CosmoTheoretician/acoustic-aircraft-array/out/analysis/doa_vs_elevation.png

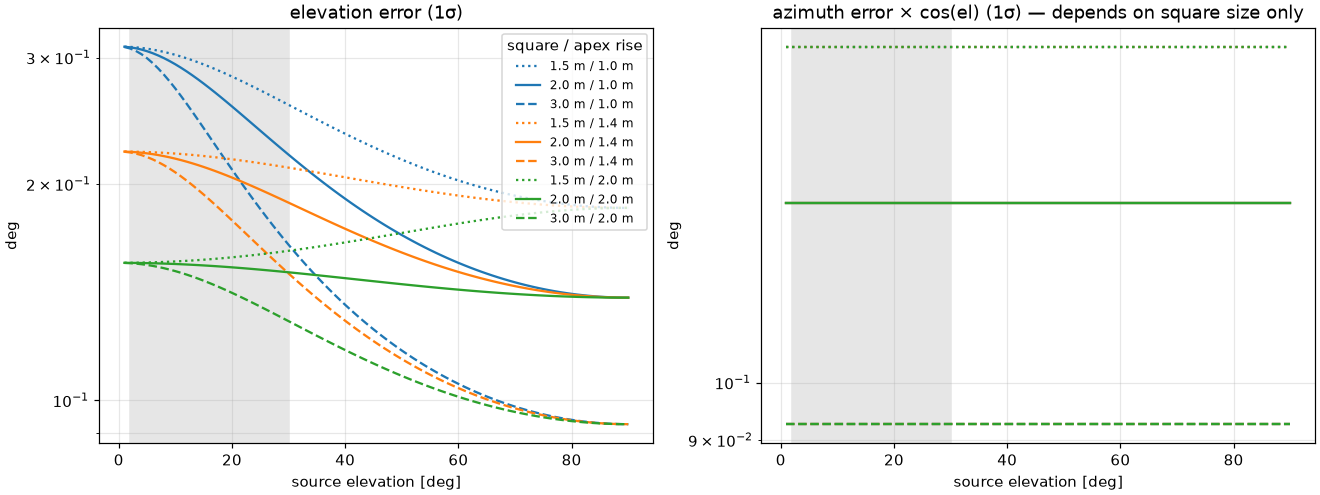
out/analysis/doa_vs_elevation.png
