CosmoTheoretician/acoustic-aircraft-array/out/analysis/tracking_nominal.png

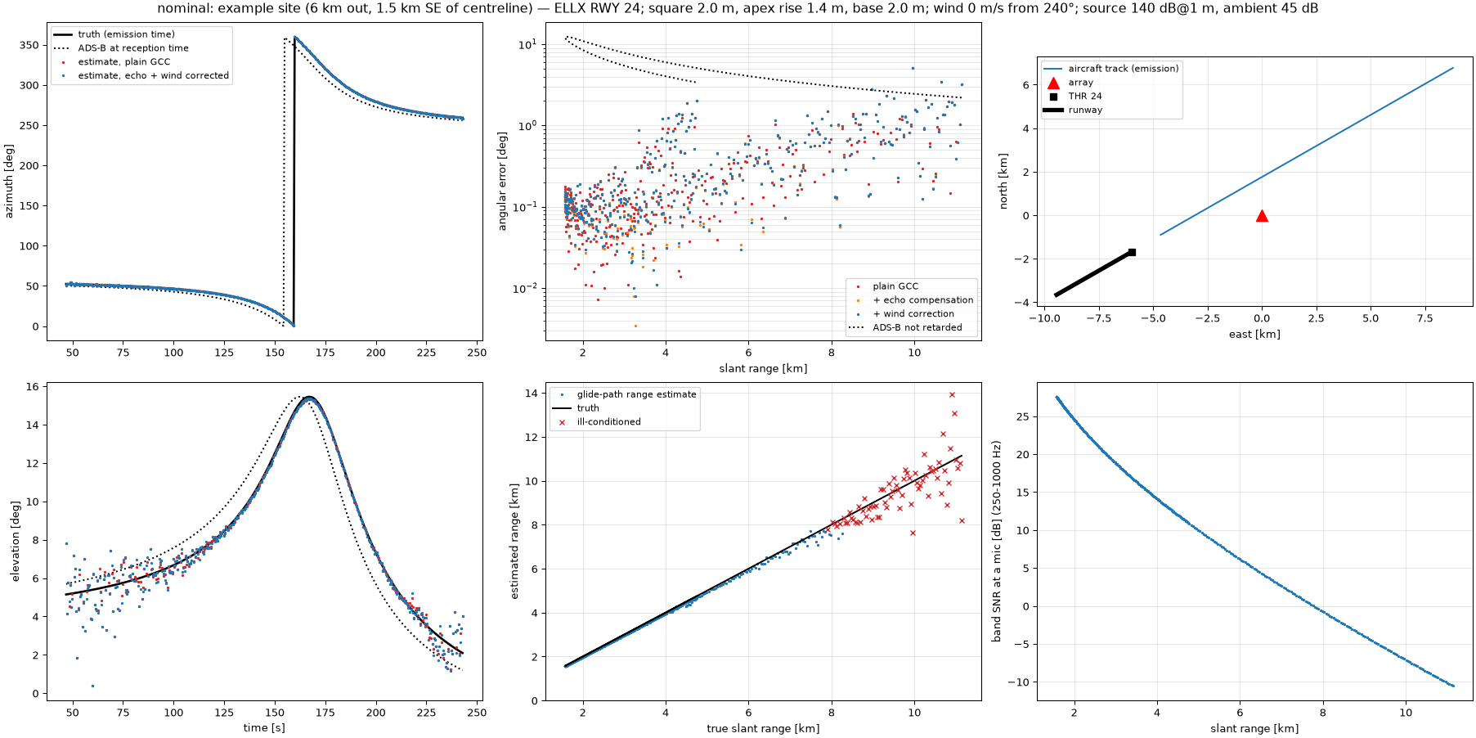
out/analysis/tracking_nominal.png
