CosmoTheoretician/acoustic-aircraft-array/out/render/cpe_closeup.png

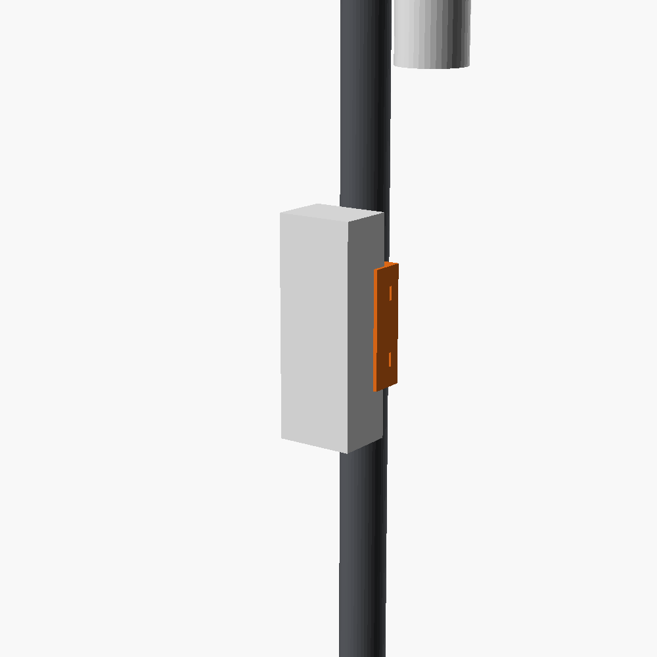
out/render/cpe_closeup.png
