CosmoTheoretician/acoustic-aircraft-array/out/render/iso_northwest.png

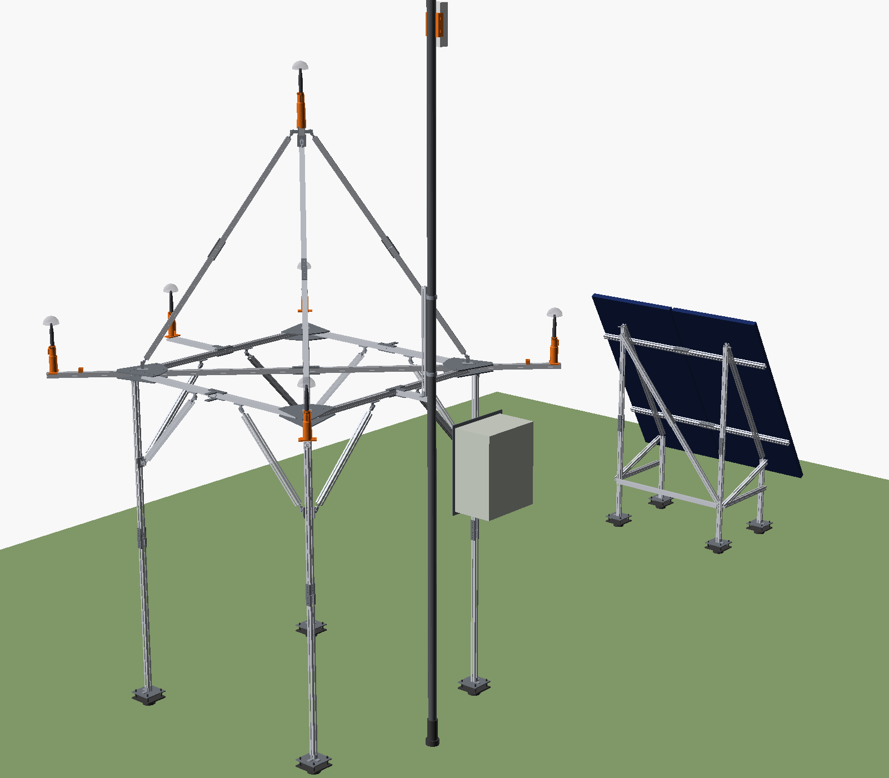
out/render/iso_northwest.png
