CosmoTheoretician/acoustic-aircraft-array/out/render/iso_southeast.png

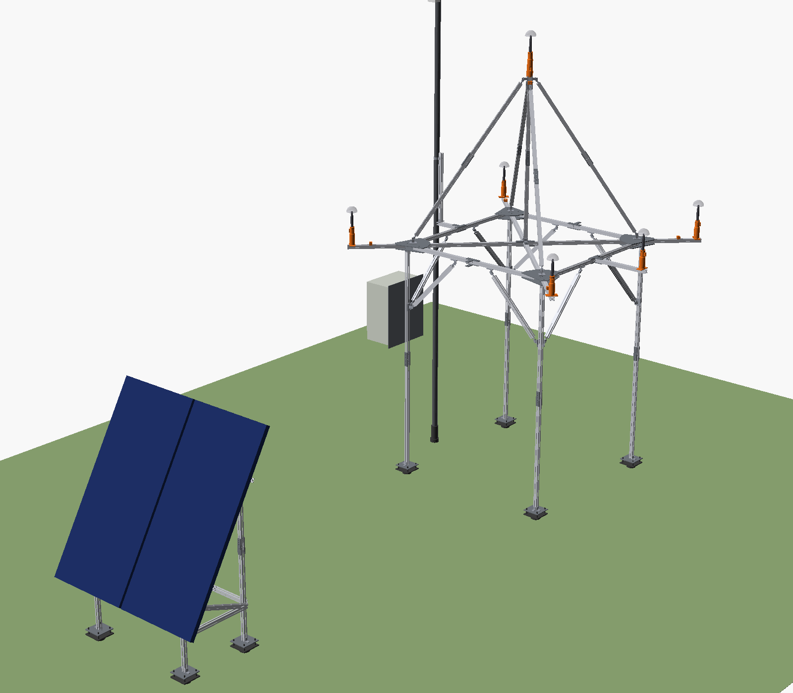
out/render/iso_southeast.png
