CosmoTheoretician/acoustic-aircraft-array/out/render/south_elevation.png

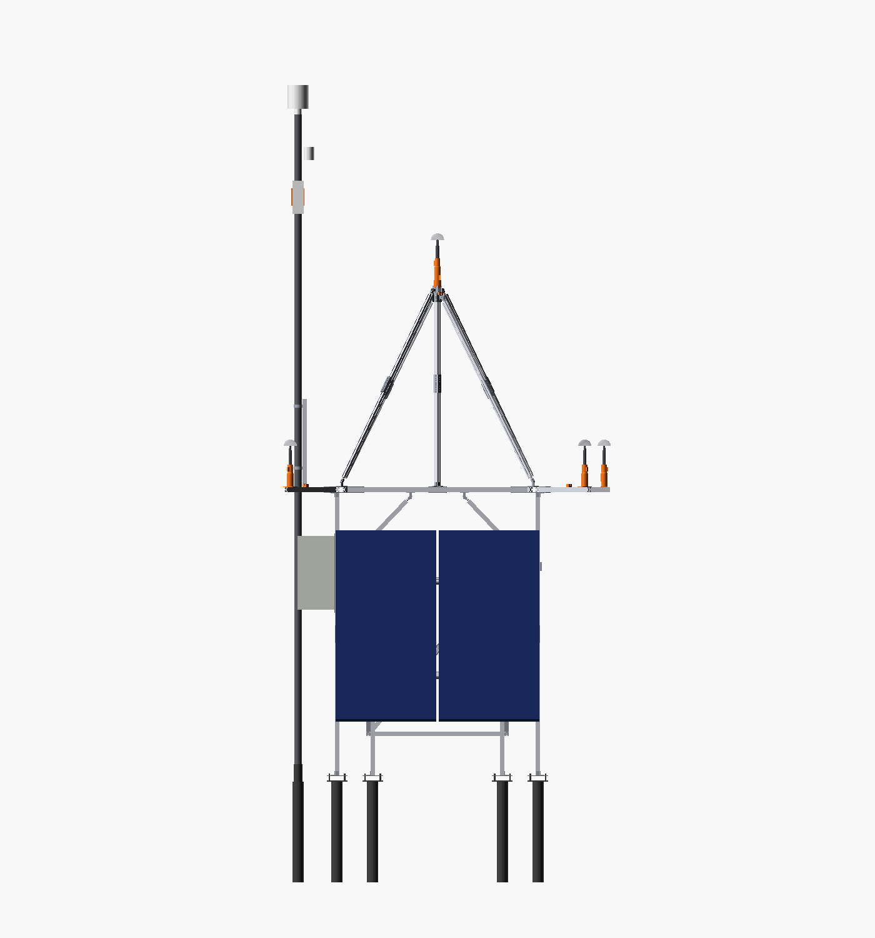
out/render/south_elevation.png
