CosmoTheoretician/acoustic-aircraft-array/out/render/top.png

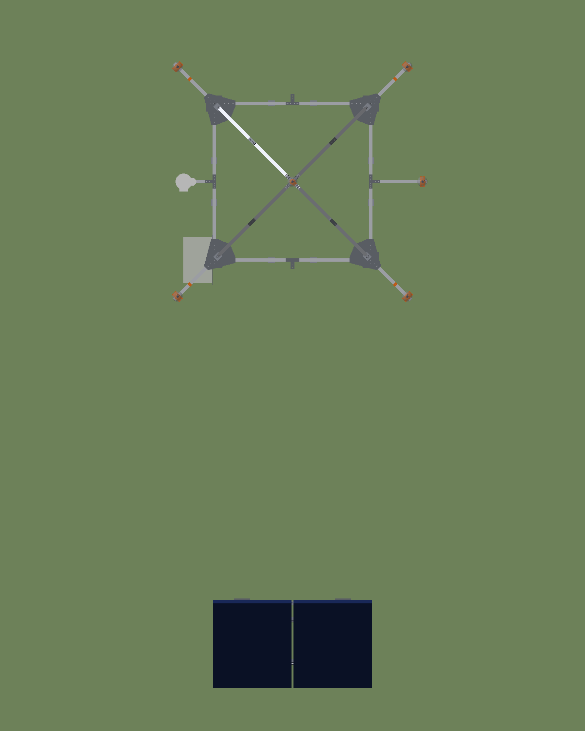
out/render/top.png
