CosmoTheoretician/acoustic-aircraft-array/out/bom.csv

category | item | spec | qty | notes
profile | 3030 extrusion — arm | cut 874.2 mm, square ends | 4 | H7 through-hole 20 mm from outer end, 27 mm from hub end
profile | 3030 extrusion — outrigger | cut 470.0 mm, square ends | 4 | H7 through-holes 20 mm from inner end and 430 mm (mic holder dowel)
profile | 3030 extrusion — side_half | cut 610.3 mm, square ends | 8 | H7 through-holes 20 mm from the corner end, 30 mm from the mid end, and 430 mm from the corner end (knee-brace clevis, underside) (standard lugs: no pre-drilled hole, match-drill through the lug)
profile | 3030 extrusion — leg | cut 958.0 mm, square ends | 8 | tap core M8 both ends; H7 through-holes at 1418 mm from the foot (knee clevises, 2 faces) (standard lugs: no pre-drilled hole, match-drill through the lug); spliced end(s): through-hole 30 mm from end
profile | 3030 extrusion — knee_brace | cut 575.7 mm, square ends | 8 | tap core M8 both ends for fork heads; pin-to-pin 655.7 mm: set once on the jig, lock the jam nuts, paint-mark the threads
profile | 3030 extrusion — strut_A | cut 742.6 mm, square ends | 4 | tap core M8 both ends for fork heads; pin-to-pin 1567.2 mm: set once on the jig, lock the jam nuts, paint-mark the threads; spliced end(s): through-hole 30 mm from end
profile | 3030 extrusion — strut_B | cut 721.9 mm, square ends | 4 | tap core M8 both ends for fork heads; pin-to-pin 1525.9 mm: set once on the jig, lock the jam nuts, paint-mark the threads; spliced end(s): through-hole 30 mm from end
profile | 3030 extrusion — mast | cut 696.0 mm, square ends | 2 | tap core M8 both ends; H7 dowel holes at clevis heights 1334 and 1284 mm from foot (standard lugs: no pre-drilled hole, match-drill through the lug); spliced end(s): through-hole 30 mm from end
profile | 3030 extrusion — outrigger | cut 470.0 mm, square ends | 1 | (mic 6) same as corner outriggers
profile | 3030 extrusion — solar_rail | cut 1100.0 mm, square ends | 2 | H7 holes at both ends (post brackets)
profile | 3030 extrusion — solar_post | cut 721.5 mm, square ends | 4 | tap core M8 at the foot; spliced end(s): through-hole 30 mm from end
profile | 3030 extrusion — solar_post | cut 492.3 mm, square ends | 2 | tap core M8 at the foot
profile | 3030 extrusion — solar_tie | cut 550.0 mm, square ends | 2 | bolt through the post side slots (corner brackets)
profile | 3030 extrusion — solar_diagonal | cut 584.3 mm, square ends | 2 | drilled ends, M6 through-bolt to the post
profile | 3030 extrusion — solar_back_tie | cut 880.0 mm, square ends | 1 | corner brackets to the back posts
profile | 3030 extrusion — solar_back_diagonal | cut 699.4 mm, square ends | 2 | drilled ends, M6 through-bolt to the posts; spliced end(s): through-hole 30 mm from end
profile | 3030 extrusion — solar_cross_rail | cut 689.0 mm, square ends | 4 | panel clamps; bolt to the inclined rails with corner brackets; spliced end(s): through-hole 30 mm from end
profile | 3030 extrusion — pole_stub | cut 250.0 mm, square ends | 1 | H7 through-hole 20 mm from inner end
profile | 3030 extrusion — pole_post | cut 600.0 mm, square ends | 1 | tap core bottom end
profile | 3030 extrusion — total length | 44.47 m (+ saw kerf)
plate | hub_top | catalogue cross joining plate 3030, arms 30 wide, ~154 tip to tip, t=6 mm, envelope 130 x 130 mm, DXF plates/hub_top.dxf | 1 | match-drill the dowel holes in place with the jig (ream H7), then number the plate; 4 dowel holes 6 H7 (ream), other holes per DXF
plate | hub_bottom | catalogue cross joining plate 3030, arms 30 wide, ~154 tip to tip, t=6 mm, envelope 130 x 130 mm, DXF plates/hub_bottom.dxf | 1 | match-drill the dowel holes in place with the jig (ream H7), then number the plate; 4 dowel holes 6 H7 (ream), other holes per DXF
plate | corner_gusset | Al 5083/6082, t=6 mm, envelope 273 x 273 mm, DXF plates/corner_gusset.dxf | 8 | 4 dowel holes 6 H7 (ream), other holes per DXF
plate | splice | catalogue straight joining plate 3030, ~122 x 30, t=6 mm, envelope 122 x 30 mm, DXF plates/splice.dxf | 28 | match-drill the dowel holes in place with the jig (ream H7), then number the plate; 2 dowel holes 6 H7 (ream), other holes per DXF
plate | leg_base | galvanised steel flat plate (S235), drilled per DXF, t=6 mm, envelope 140 x 140 mm, DXF plates/leg_base.dxf | 8 | no dowels: levelling studs set the height; 0 dowel holes 6 H7 (ream), other holes per DXF
plate | midside_tee | catalogue T joining plate 3030, ~95 x 123, t=6 mm, envelope 95 x 123 mm, DXF plates/midside_tee.dxf | 8 | match-drill the dowel holes in place with the jig (ream H7), then number the plate; 3 dowel holes 6 H7 (ream), other holes per DXF
bought | Corner bracket 3030 (28x28 cast) |  | 34
bought | Ground screw 76 x 650 mm with 140 x 140 mm head plate, galvanised |  | 8
bought | Al T-section 50x50x5 stock, 60 mm pieces (web trimmed to 18 mm, 8.2 mm pin hole at 32 mm, 2 x 6.6 + 1 dowel hole) — pin lug |  | 24
bought | Fork head DIN 71752 G8x16, stainless (A4) (pin: see clevis pins) |  | 24
bought | Al plate 540 x 440 x 4 mm (box mounting plate on leg) |  | 1
bought | Weatherproof enclosure 400x500x250 mm IP66, vent membrane + cable glands |  | 1
bought | PV panel ~200 W 12 V mono, 680 x 1480 x 35 mm |  | 2
bought | MPPT charge controller 12 V 20 A with low-temperature charge cut-off (LiFePO4) |  | 1
bought | LiFePO4 battery 12.8 V 100 Ah (~1.3 kWh, ~2 days at the ~25 W system load), in the box |  | 1
bought | PV cable 4 mm2 ~6 m in buried/armoured conduit + MC4 + 15 A fuse |  | 1
bought | Ground screw 76 x 650 mm with 48.3 mm pole sleeve + clamp bolt, galvanised |  | 1
bought | Aluminium or galvanised tube 48.3 mm, 4.8 m (2 parts + internal sleeve joint for transport) |  | 1
bought | U-bolt pole clamp for 48.3 mm pole onto 3030 slot, A4 |  | 2
bought | Ultrasonic 2D wind sensor (e.g. Gill WindSonic class), ~142 mm, pole-top mount |  | 1
bought | TP-Link CPE210 (2.4 GHz, 9 dBi, 65 deg H / 35 deg V beam) + its pole strap |  | 1
bought | Hose clamp 12 mm W4 stainless, 40-70 mm (spare strap for the CPE saddle) |  | 1
bought | Sky camera + pole bracket (user supplied) |  | 1
bought | Armoured / steel-braided cable conduit, marten-proof (all cables, legs to box) |  | 1
fastener | Clevis pin 8 x 24 mm DIN 1444, A4 + R-clip |  | 24 | add ~10 % spares
fastener | Dowel pin 6 m6 x 20 ISO 8734, stainless 1.4305 |  | 145 | add ~10 % spares
fastener | M10 threaded rod 90 mm A4 + 3 nuts + 2 washers (levelling stud) |  | 32 | add ~10 % spares
fastener | M3x16 socket head + M3 nut, A4 (collar) |  | 6 | add ~10 % spares
fastener | M4x30 socket head + M4 nyloc, A4 (holder clamp) |  | 6 | add ~10 % spares
fastener | M5x16 + washer A4 (box to plate) |  | 4 | add ~10 % spares
fastener | M6 nyloc nut DIN 985, A4 |  | 48 | add ~10 % spares
fastener | M6 washer DIN 125, A4 |  | 48 | add ~10 % spares
fastener | M6x12 button head ISO 7380, A4 stainless |  | 330 | add ~10 % spares
fastener | M6x20 button head ISO 7380, A4 stainless |  | 48 | add ~10 % spares
fastener | M6x25 button head ISO 7380, A4 stainless |  | 5 | add ~10 % spares
fastener | M6x50 + nyloc A4 (solar diagonal) |  | 4 | add ~10 % spares
fastener | M8 jam nut DIN 439, A4 |  | 24 | add ~10 % spares
fastener | M8x16 socket head ISO 4762, A4 + washer (apex holder -> mast) |  | 1 | add ~10 % spares
fastener | M8x16 socket head ISO 4762, A4 + washer (leg -> gusset / base plate) |  | 8 | add ~10 % spares
fastener | M8x16 socket head ISO 4762, A4 + washer (mast -> hub) |  | 1 | add ~10 % spares
fastener | M8x16 socket head ISO 4762, A4 + washer (post -> stub) |  | 1 | add ~10 % spares
fastener | M8x16 socket head ISO 4762, A4 + washer (solar post -> base plate) |  | 4 | add ~10 % spares
fastener | Nylon washer 8.4 x 16 x 1.5 (fork-head spacer) |  | 48 | add ~10 % spares
fastener | PV mid/end clamp 35 mm frame, aluminium + M8 T-bolt |  | 6 | add ~10 % spares
fastener | T-nut M6 for slot 8 (hammer or drop-in), A2/A4 stainless |  | 335 | add ~10 % spares
printed | mic_holder_flange | ASA, 5 walls, 50 % infill, print flange-down | 5 | stl/mic_holder_flange.stl
printed | iso_sleeve_tpu | TPU 85A-95A (or cut from EPDM tube 22x28 mm) | 6 | stl/iso_sleeve_tpu.stl
printed | index_collar | ASA or PETG | 6 | stl/index_collar.stl
printed | cable_clip | ASA/PETG (TPU also works) | 5 | stl/cable_clip.stl
printed | mic_holder_socket | ASA, 5 walls, 50 % infill, print socket-up | 1 | stl/mic_holder_socket.stl
printed | cpe_pole_saddle | ASA, 4 walls, 40 % infill, print on its side | 1 | stl/cpe_pole_saddle.stl
bought | Foam windscreen + furry cover | ~90 mm ball | 6
bought | XLR cable, outdoor PUR | length to suit box | 6
