CosmoTheoretician/acoustic-aircraft-array/out/cost_estimate.csv

group | item | spec | qty | eur_low | eur_high | comment
frame | 3030 extrusion — arm | 4 x 874 mm | 4 | 28 | 43 | incl. cutting
frame | 3030 extrusion — outrigger | 4 x 470 mm | 4 | 16 | 25 | incl. cutting
frame | 3030 extrusion — side_half | 8 x 610 mm | 8 | 41 | 63 | incl. cutting
frame | 3030 extrusion — leg | 8 x 958 mm | 8 | 61 | 94 | incl. cutting
frame | 3030 extrusion — knee_brace | 8 x 576 mm | 8 | 39 | 60 | incl. cutting
frame | 3030 extrusion — strut_A | 4 x 743 mm | 4 | 24 | 37 | incl. cutting
frame | 3030 extrusion — strut_B | 4 x 722 mm | 4 | 24 | 37 | incl. cutting
frame | 3030 extrusion — mast | 2 x 696 mm | 2 | 11 | 18 | incl. cutting
frame | 3030 extrusion — outrigger | 1 x 470 mm | 1 | 4 | 6 | incl. cutting
frame | 3030 extrusion — solar_rail | 2 x 1100 mm | 2 | 18 | 27 | incl. cutting
frame | 3030 extrusion — solar_post | 4 x 722 mm | 4 | 24 | 37 | incl. cutting
frame | 3030 extrusion — solar_post | 2 x 492 mm | 2 | 8 | 13 | incl. cutting
frame | 3030 extrusion — solar_tie | 2 x 550 mm | 2 | 9 | 15 | incl. cutting
frame | 3030 extrusion — solar_diagonal | 2 x 584 mm | 2 | 10 | 15 | incl. cutting
frame | 3030 extrusion — solar_back_tie | 1 x 880 mm | 1 | 7 | 11 | incl. cutting
frame | 3030 extrusion — solar_back_diagonal | 2 x 699 mm | 2 | 11 | 18 | incl. cutting
frame | 3030 extrusion — solar_cross_rail | 4 x 689 mm | 4 | 23 | 35 | incl. cutting
frame | 3030 extrusion — pole_stub | 1 x 250 mm | 1 | 2 | 4 | incl. cutting
frame | 3030 extrusion — pole_post | 1 x 600 mm | 1 | 5 | 8 | incl. cutting
frame | Cross joining plate 3030, 4-arm (catalogue), match-drilled for dowels + mast [hub_top] | catalogue cross joining plate 3030 | 1 | 6 | 12 | dowels match-drilled
frame | Cross joining plate 3030, 4-arm (catalogue), match-drilled for dowels [hub_bottom] | catalogue cross joining plate 3030 | 1 | 6 | 12 | dowels match-drilled
frame | Plate corner_gusset (6 mm Al, laser/waterjet) | envelope 273 x 273 mm | 8 | 233 | 406 | reamed dowel holes DIY
frame | Straight joining plate 3030, >=120 mm, 4 holes (catalogue), match-drilled [splice] | catalogue straight joining plate 3030 | 28 | 70 | 126 | dowels match-drilled
frame | Galvanised steel base plate ~120 x 120 x 6, drilled to the screw-head studs [leg_base] | galvanised steel flat plate (S235) | 8 | 32 | 64 | dowels match-drilled
frame | T joining plate 3030 (catalogue), match-drilled for dowels [midside_tee] | catalogue T joining plate 3030 | 8 | 24 | 48 | dowels match-drilled
frame | Corner bracket 3030 (28x28 cast) |  | 34 | 27 | 61 | cast Zn/Al, 28x28
frame | Ground screw 76 x 650 mm with 140 x 140 mm head plate, galvanised |  | 8 | 144 | 240 | galvanised, 650 mm
frame | Al T-section 50x50x5 stock, 60 mm pieces (web trimmed to 18 mm, 8.2 mm pin hole at 32 mm, 2 x 6.6 + 1 dowel hole) — pin lug |  | 24 | 24 | 48 | cut from ~1.5 m of stock
frame | Fork head DIN 71752 G8x16, stainless (A4) (pin: see clevis pins) |  | 24 | 72 | 144 | stainless G8x16
frame | Al plate 540 x 440 x 4 mm (box mounting plate on leg) |  | 1 | 15 | 30
frame | Ground screw 76 x 650 mm with 48.3 mm pole sleeve + clamp bolt, galvanised |  | 1 | 25 | 40
fasteners | Clevis pin 8 x 24 mm DIN 1444, A4 + R-clip |  | 26 | 26 | 53
fasteners | Dowel pin 6 m6 x 20 ISO 8734, stainless 1.4305 |  | 160 | 40 | 80
fasteners | M10 threaded rod 90 mm A4 + 3 nuts + 2 washers (levelling stud) |  | 35 | 42 | 77 | per stud set
fasteners | M3x16 socket head + M3 nut, A4 (collar) |  | 7 | 1 | 2
fasteners | M4x30 socket head + M4 nyloc, A4 (holder clamp) |  | 7 | 1 | 3
fasteners | M5x16 + washer A4 (box to plate) |  | 4 | 1 | 1
fasteners | M6 nyloc nut DIN 985, A4 |  | 53 | 4 | 8
fasteners | M6 washer DIN 125, A4 |  | 53 | 2 | 3
fasteners | M6x12 button head ISO 7380, A4 stainless |  | 363 | 44 | 91
fasteners | M6x20 button head ISO 7380, A4 stainless |  | 53 | 6 | 13
fasteners | M6x25 button head ISO 7380, A4 stainless |  | 6 | 1 | 1
fasteners | M6x50 + nyloc A4 (solar diagonal) |  | 4 | 2 | 3
fasteners | M8 jam nut DIN 439, A4 |  | 26 | 2 | 5
fasteners | M8x16 socket head ISO 4762, A4 + washer (apex holder -> mast) |  | 1 | 0 | 1
fasteners | M8x16 socket head ISO 4762, A4 + washer (leg -> gusset / base plate) |  | 9 | 2 | 4
fasteners | M8x16 socket head ISO 4762, A4 + washer (mast -> hub) |  | 1 | 0 | 1
fasteners | M8x16 socket head ISO 4762, A4 + washer (post -> stub) |  | 1 | 0 | 1
fasteners | M8x16 socket head ISO 4762, A4 + washer (solar post -> base plate) |  | 4 | 1 | 2
fasteners | Nylon washer 8.4 x 16 x 1.5 (fork-head spacer) |  | 53 | 3 | 6
fasteners | PV mid/end clamp 35 mm frame, aluminium + M8 T-bolt |  | 7 | 16 | 33
fasteners | T-nut M6 for slot 8 (hammer or drop-in), A2/A4 stainless |  | 369 | 111 | 221 | stainless hammer nuts
printed | mic_holder_flange | ASA, 5 walls, 50 % infill, print flange-down | 5 | 8 | 15 | filament only
printed | iso_sleeve_tpu | TPU 85A-95A (or cut from EPDM tube 22x28 mm) | 6 | 3 | 9 | filament only
printed | index_collar | ASA or PETG | 6 | 9 | 18 | filament only
printed | cable_clip | ASA/PETG (TPU also works) | 5 | 2 | 8 | filament only
printed | mic_holder_socket | ASA, 5 walls, 50 % infill, print socket-up | 1 | 2 | 3 | filament only
printed | cpe_pole_saddle | ASA, 4 walls, 40 % infill, print on its side | 1 | 2 | 3 | filament only
pole | Aluminium or galvanised tube 48.3 mm, 4.8 m (2 parts + internal sleeve joint for transport) |  | 1 | 45 | 90 | incl. internal sleeve
pole | U-bolt pole clamp for 48.3 mm pole onto 3030 slot, A4 |  | 2 | 12 | 24
pole | Hose clamp 12 mm W4 stainless, 40-70 mm (spare strap for the CPE saddle) |  | 1 | 2 | 3
pole | Earth rod + 16 mm2 cable for the pole (tallest point in the garden) |  | 1 | 30 | 60
microphones | Foam windscreen + furry cover | ~90 mm ball | 6 | 48 | 150 | foam + furry cover
microphones | XLR cable, outdoor PUR | length to suit box | 6 | 90 | 180 | PUR outdoor, 5-8 m
microphones | Behringer ECM8000 measurement mic (5 + optional 6th) |  | 6 | 150 | 240
sensors | Ultrasonic 2D wind sensor (e.g. Gill WindSonic class), ~142 mm, pole-top mount |  | 1 | 250 | 1400 | generic RS485 ultrasonic ... Gill WindSonic
sensors | Sky camera + pole bracket (user supplied) |  | 1 | 60 | 250 | e.g. Raspberry Pi HQ camera + fisheye + housing
electronics | Audio interface, 8 phantom-powered inputs, one sample clock (e.g. Behringer UMC1820) |  | 1 | 230 | 320 | all mics on ONE converter clock; TDOA needs it
electronics | 12 V -> 230 V pure-sine inverter 150 W (for a mains-powered interface) |  | 1 | 50 | 100 | skip if the interface runs on 12 V DC
electronics | Raspberry Pi 5 8 GB + case + NVMe SSD + 12 V->5 V 5 A converter |  | 1 | 140 | 210
electronics | ADS-B receiver: RTL-SDR v4 + 1090 MHz filter + antenna |  | 1 | 70 | 130 | validation truth
network | TP-Link CPE210 (2.4 GHz, 9 dBi, 65 deg H / 35 deg V beam) + its pole strap |  | 1 | 40 | 55
network | TP-Link CPE210, far end of the link (at the house) + PoE injector |  | 1 | 40 | 55 | a link needs 2
network | Outdoor Ethernet cable (CAT6 PE) for the CPE210, ~10 m + glands |  | 1 | 15 | 30
power | Weatherproof enclosure 400x500x250 mm IP66, vent membrane + cable glands |  | 1 | 80 | 160 | polycarbonate IP66 (Fibox/Spelsberg class)
power | PV panel ~200 W 12 V mono, 680 x 1480 x 35 mm |  | 2 | 160 | 260 | 200 W mono
power | MPPT charge controller 12 V 20 A with low-temperature charge cut-off (LiFePO4) |  | 1 | 90 | 130 | e.g. Victron SmartSolar 100/20
power | LiFePO4 battery 12.8 V 100 Ah (~1.3 kWh, ~2 days at the ~25 W system load), in the box |  | 1 | 250 | 400 | with low-temperature charge protection
power | PV cable 4 mm2 ~6 m in buried/armoured conduit + MC4 + 15 A fuse |  | 1 | 30 | 60
power | Armoured / steel-braided cable conduit, marten-proof (all cables, legs to box) |  | 1 | 90 | 180 | ~25-30 m
power | Box internals: DIN rail, fuses, terminals, DC-DC 12->24 V passive PoE |  | 1 | 40 | 80
tools | Reamers 6 H7 (dowels) + 8 H8 (pins), M8 tap, drill-jig bushings |  | 1 | 50 | 100 | DIY machining
tools | Core tapping of profile ends (if done by the extrusion shop) |  | 30 | 30 | 60 | or DIY with the tap
TOTAL |  |  |  | 3465 | 7188
