CosmoTheoretician/acoustic-aircraft-array/out/array_assembly.step

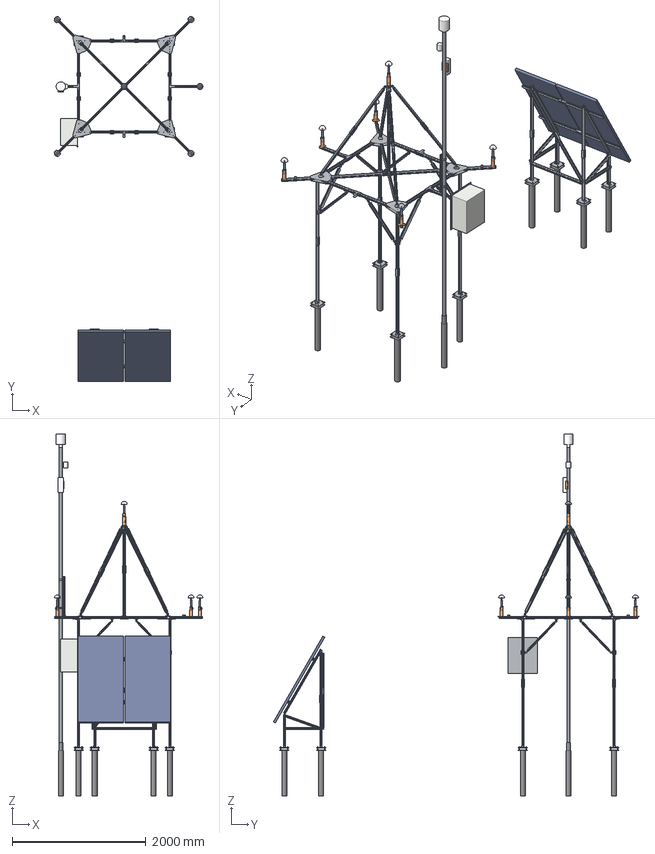
[picture p20: CAD file, 2026-11-10]
out/array_assembly.step
2225.6 x 5459.9 x 5410.0 mm
plate_hub_top_1
plate_hub_bottom_1
arm_1
outrigger_1
side_half_1
side_half_2
plate_corner_gusset_1
plate_corner_gusset_2
leg_1
leg_2
plate_splice_1
plate_splice_2
angle_bracket_1
angle_bracket_2
plate_leg_base_1
angle_bracket_3
angle_bracket_4
ground_screw_1
pin_lug_1
clevis_pin_1
pin_lug_2
clevis_pin_2
knee_brace_1
fork_head_1
fork_head_2
pin_lug_3
clevis_pin_3
pin_lug_4
clevis_pin_4
knee_brace_2
fork_head_3
fork_head_4
pin_lug_5
clevis_pin_5
pin_lug_6
clevis_pin_6
strut_A_1
strut_A_2
plate_splice_3
plate_splice_4
fork_head_5
fork_head_6
print_mic_holder_flange_1
mic_1
print_sleeve_tpu_1
print_index_collar_1
xlr_plug_1
windscreen_keepout_1
print_cable_clip_1
arm_2
outrigger_2
side_half_3
side_half_4
plate_corner_gusset_3
plate_corner_gusset_4
leg_3
leg_4
plate_splice_5
plate_splice_6
angle_bracket_5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
