CosmoTheoretician/acoustic-aircraft-array/out/plates/splice.dxf

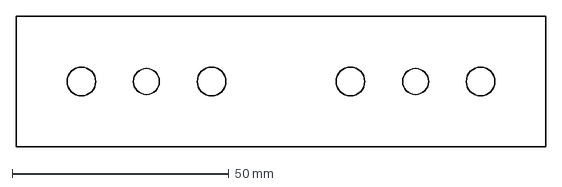
[picture p21: CAD file, 2026-11-10]
out/plates/splice.dxf
122.0 x 30.0 mm
