CosmoTheoretician/acoustic-aircraft-array/out/stl/cpe_pole_saddle.stl

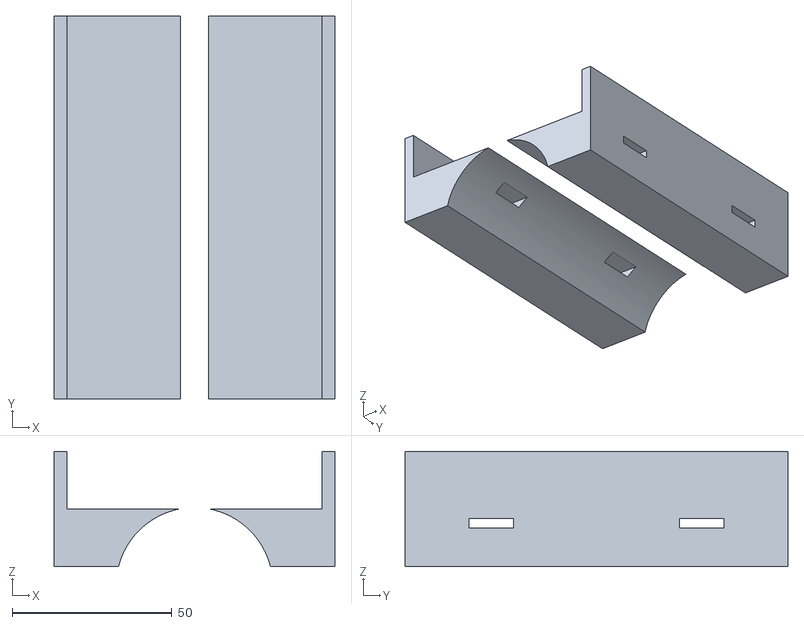
[picture p22: CAD file, 2026-11-10]
out/stl/cpe_pole_saddle.stl
88.0 x 120.0 x 36.1
