CosmoTheoretician/acoustic-aircraft-array/out/plates/midside_tee.dxf

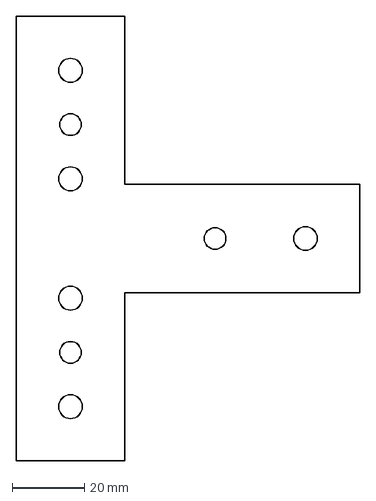
[picture p23: CAD file, 2026-11-10]
out/plates/midside_tee.dxf
95.0 x 123.0 mm
