CosmoTheoretician/acoustic-aircraft-array/out/stl/mic_holder_flange.stl

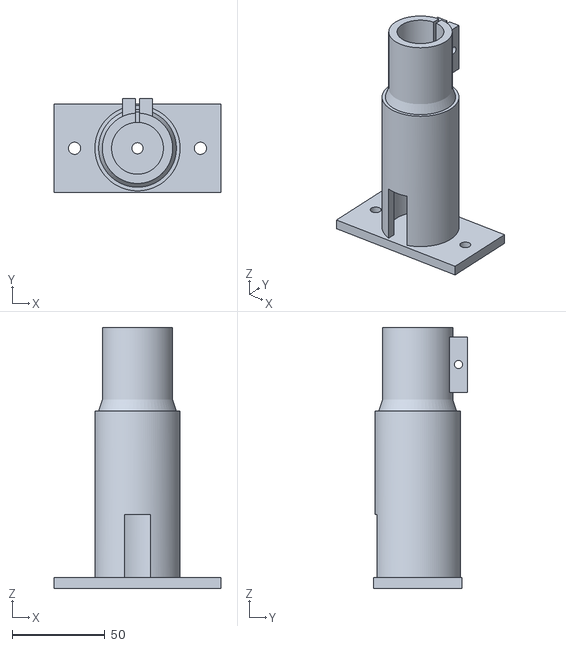
[picture p24: CAD file, 2026-11-10]
out/stl/mic_holder_flange.stl
90.0 x 51.0 x 141.0
