CosmoTheoretician/acoustic-aircraft-array/out/plates/corner_gusset.dxf

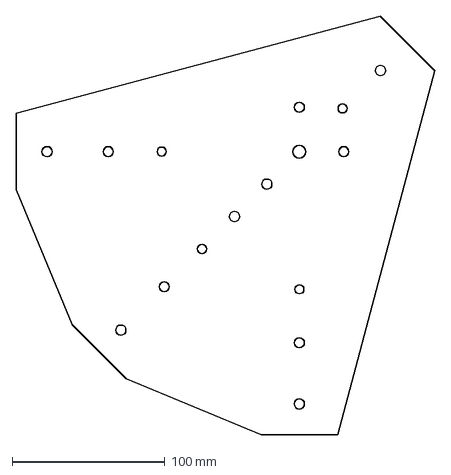
[picture p25: CAD file, 2026-11-10]
out/plates/corner_gusset.dxf
273.4 x 273.4 mm
