CosmoTheoretician/acoustic-aircraft-array/out/stl/index_collar.stl

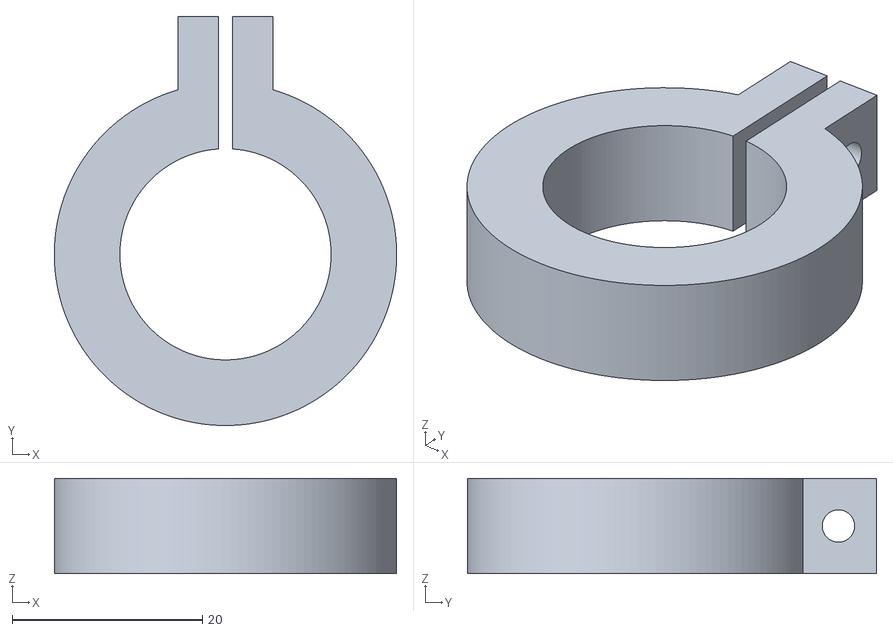
[picture p26: CAD file, 2026-11-10]
out/stl/index_collar.stl
36.0 x 43.0 x 10.0
