CosmoTheoretician/acoustic-aircraft-array/out/plates/hub_top.dxf

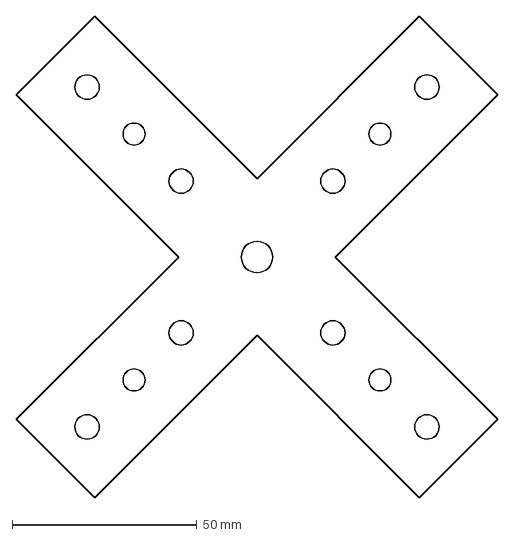
[picture p27: CAD file, 2026-11-10]
out/plates/hub_top.dxf
130.1 x 130.1 mm
