CosmoTheoretician/acoustic-aircraft-array/out/stl/cable_clip.stl

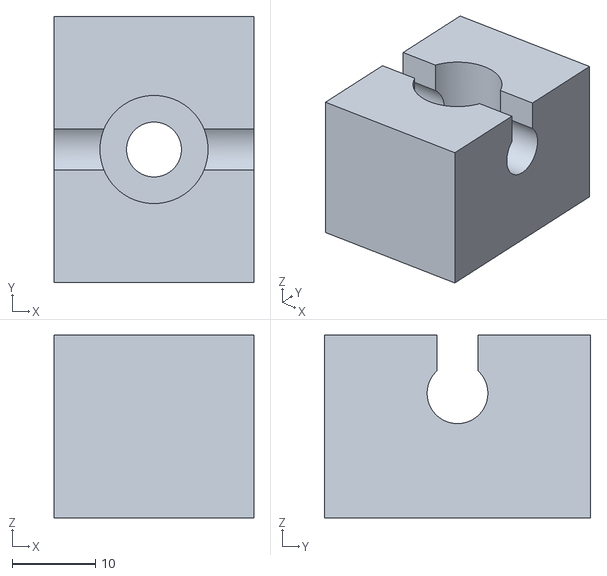
[picture p28: CAD file, 2026-11-10]
out/stl/cable_clip.stl
24.0 x 32.0 x 22.0
