CosmoTheoretician/acoustic-aircraft-array/out/plates/hub_bottom.dxf

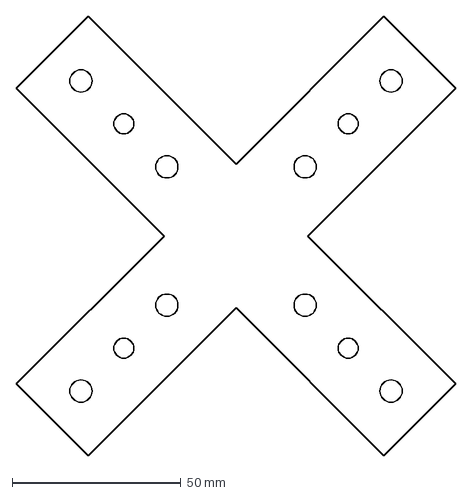
[picture p29: CAD file, 2026-11-10]
out/plates/hub_bottom.dxf
130.1 x 130.1 mm
