CosmoTheoretician/acoustic-aircraft-array/out/stl/mic_holder_socket.stl

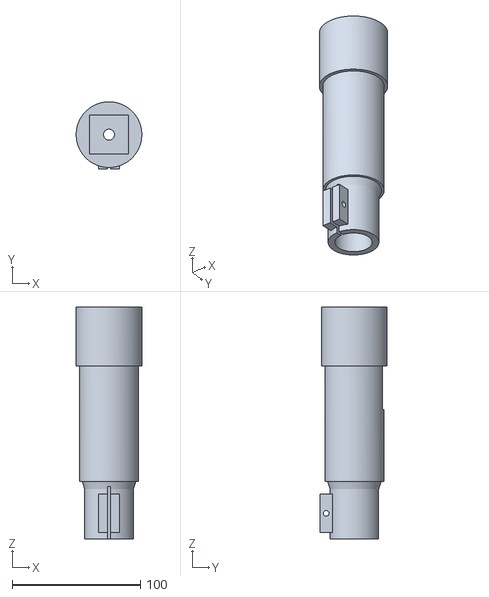
[picture p30: CAD file, 2026-11-10]
out/stl/mic_holder_socket.stl
51.3 x 52.6 x 181.0
