CosmoTheoretician/acoustic-aircraft-array/out/plates/leg_base.dxf

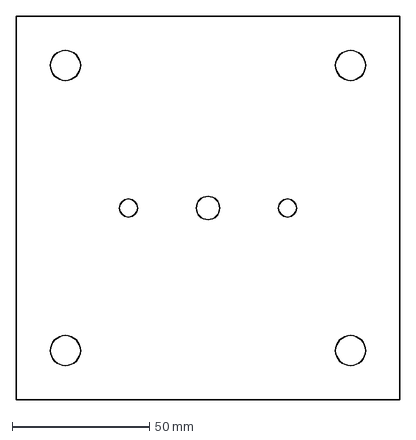
[picture p31: CAD file, 2026-11-10]
out/plates/leg_base.dxf
140.0 x 140.0 mm
