CosmoTheoretician/acoustic-aircraft-array/out/stl/iso_sleeve_tpu.stl

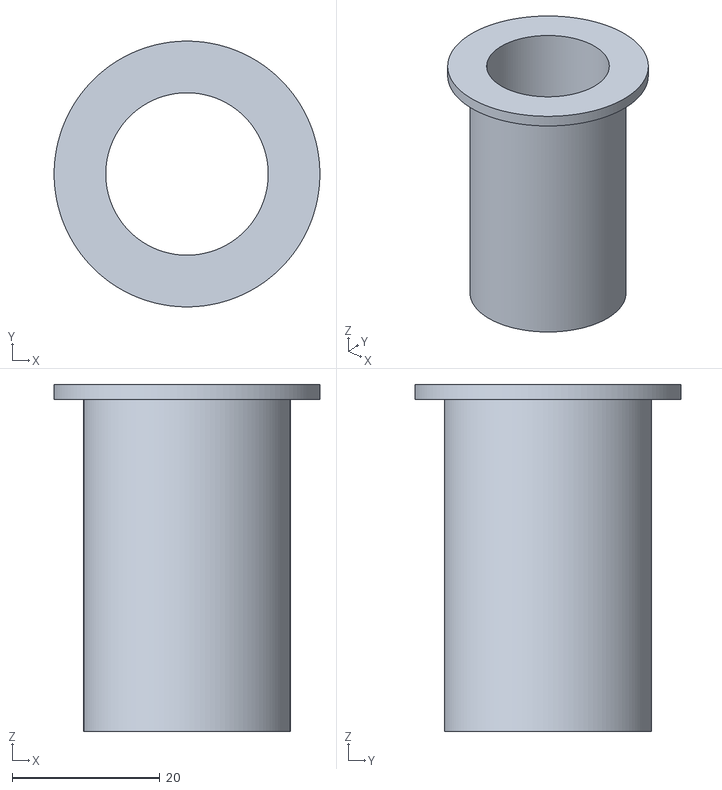
[picture p32: CAD file, 2026-11-10]
out/stl/iso_sleeve_tpu.stl
36.0 x 36.0 x 47.0
