CosmoTheoretician/acoustic-aircraft-array/out/plates/ground_board.dxf

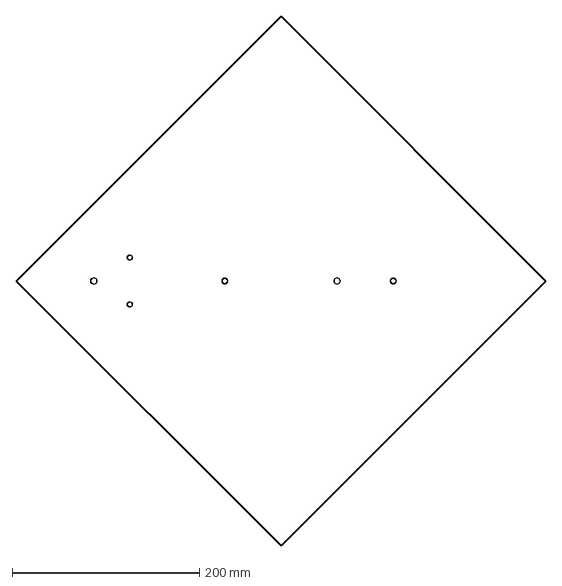
[picture p33: CAD file, 2026-11-10]
out/plates/ground_board.dxf
565.7 x 565.7 mm
