CosmoTheoretician/acoustic-aircraft-array/(commit log)

2026-11-10 Parametric acoustic aircraft-tracking array: CAD model, DOA analysis, tracking simulation
    - array_params.py: single source of truth for geometry and mic coordinates
    - array_model.py: CadQuery model; exports STEP, printed-part STLs, plate DXFs, BOM, renders
    - doa_analysis.py: CRLB sky maps comparing square sizes and mast heights
    - tracking_sim.py: end-to-end ILS approach simulation with apex ground-echo compensation
    [apex_holder.stl, array_assembly.step, bom.csv, cable_clip.stl, corner_gusset.dxf, doa_summary.csv, ground_board.dxf, ground_cap.stl]
2026-11-10 Elevated array on legs, wind sensor, separate solar stand, ELLX simulation
    - Base frame 2 m above ground on four braced legs with ground screws; all mics
    free-field, pointing up, in identical printed holders.
    - West pole with ultrasonic wind sensor, Wi-Fi bridge and sky camera.
    - Solar on its own ground stand south of the array (60 deg, south-facing).
    - Tracking sim: real ELLX approach geometry, atmospheric absorption, wind with
    anemometer correction, ground-echo compensation with the lawn reflection
    learned from coherent frames. Private sites via git-ignored --site file.
    - DOA analysis updated for apex_rise; README rewritten.
    [array_assembly.step, bom.csv, corner_gusset.dxf, doa_summary.csv, ground_cap.stl, ground_cradle.stl, hub_bottom.dxf, hub_top.dxf]
2026-11-10 Add TP-Link CPE210 facing south with printed pole saddle
    [array_assembly.step, bom.csv, corner_gusset.dxf, cpe_pole_saddle.stl, hub_bottom.dxf, hub_top.dxf, leg_base.dxf, midside_tee.dxf]
2026-11-10 Add priced materials list (cost_estimate.py)
    [array_assembly.step, bom.csv, corner_gusset.dxf, cost_estimate.csv, hub_bottom.dxf, hub_top.dxf, leg_base.dxf, midside_tee.dxf]
2026-11-10 Cost estimate: standard-plate variant with match-drilled dowels
    [cost_estimate_standard.csv]
2026-11-10 Switch frame to catalogue joining plates and DIN 71752 fork heads
    Standard plates (hub cross, mid-side T, splices, galvanised leg feet) with
    match-drilled dowels; T-section pin lugs. Corner gussets stay custom.
    plates="custom" keeps the laser-cut variant. Cost script prices the BOM as built.
    [array_assembly.step, bom.csv, corner_gusset.dxf, cost_estimate.csv, cost_estimate_standard.csv, hub_bottom.dxf, hub_top.dxf, leg_base.dxf]
2026-11-10 Dish extension phase 1: link budgets, Doppler simulation, wind/foundation, positioner CAD + BOM
    3.5 m mesh dish on an az-el slewing-drive positioner for IM-3 S-band Doppler
    velocimetry and L-band radio astronomy. Collision sweep clean over el 0-90.
    [dish_assembly.step, dish_bom.csv]
2026-11-10 Move the dish extension to its own private repository
    Removes dish_*.py, doppler_sim.py, out/dish, the README dish section and the astropy requirement.
    [dish_assembly.step, dish_bom.csv]
2026-11-10 Add Blender Cycles photoreal renders of the array
    array_blender_export.py writes one STL per material plus scene.json;
    array_blender_render.py builds an HDRI-lit scene with 3D grass and
    procedural materials and renders seven views. README gets a gallery.
